kirch80/Trivalent-fridge-controller/Esquemas/Schematic_Trivalent-fridge-controller_power_V1.1.pdf

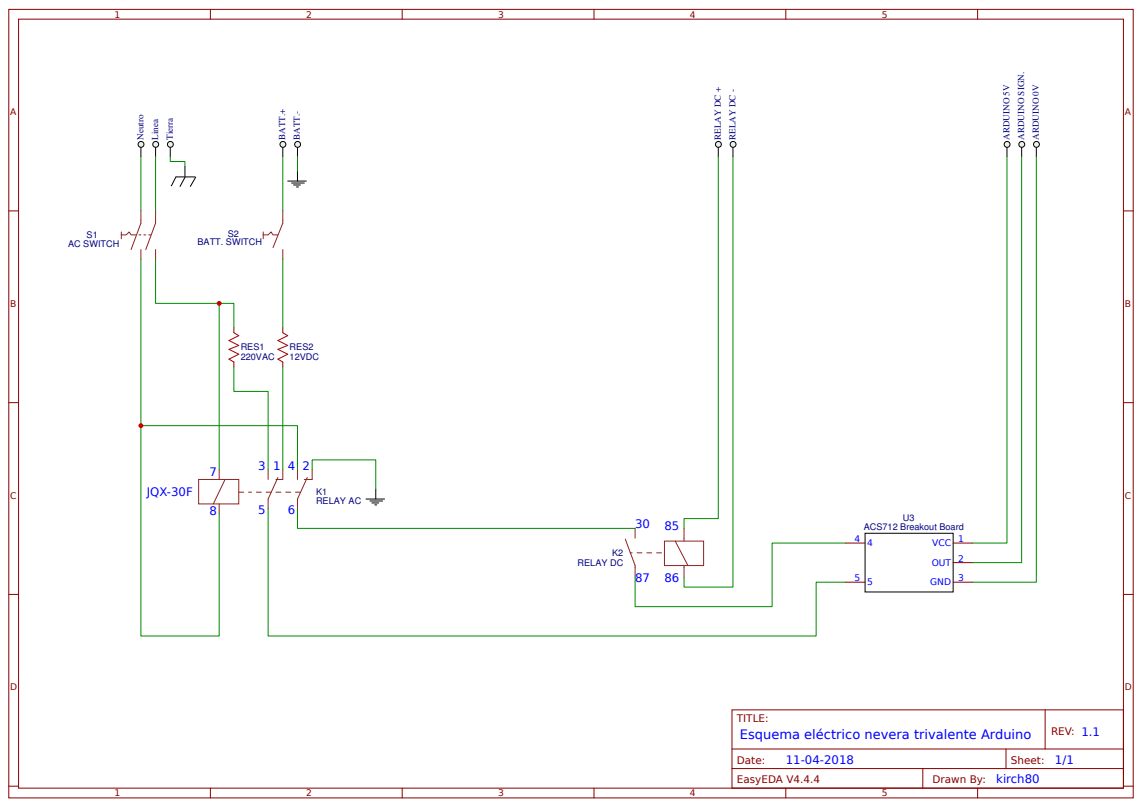
[picture p4: page 1]
TITLE:; Esquema eléctrico nevera trivalente Arduino; REV: 1.1; Date:; Sheet: 1/1; EasyEDA V4.4.4; Drawn By: kirch80; RELAY AC; AC SWITCH; BATT. SWITCH; Neutro; Linea; Tierra; BATT.+; BATT.-; 12VDC; RES2; 220VAC; RES1; RELAY DC; RELAY DC +; RELAY DC -; ACS712 Breakout Board; VCC 1; OUT 2; GND 3; ARDUINO 5V; ARDUINO SIGN.; ARDUINO 0V; JQX-30F
