kirch80/Trivalent-fridge-controller/Esquemas/Schematic_Trivalent-fridge-controller_PCB_V1.0.pdf

+5V

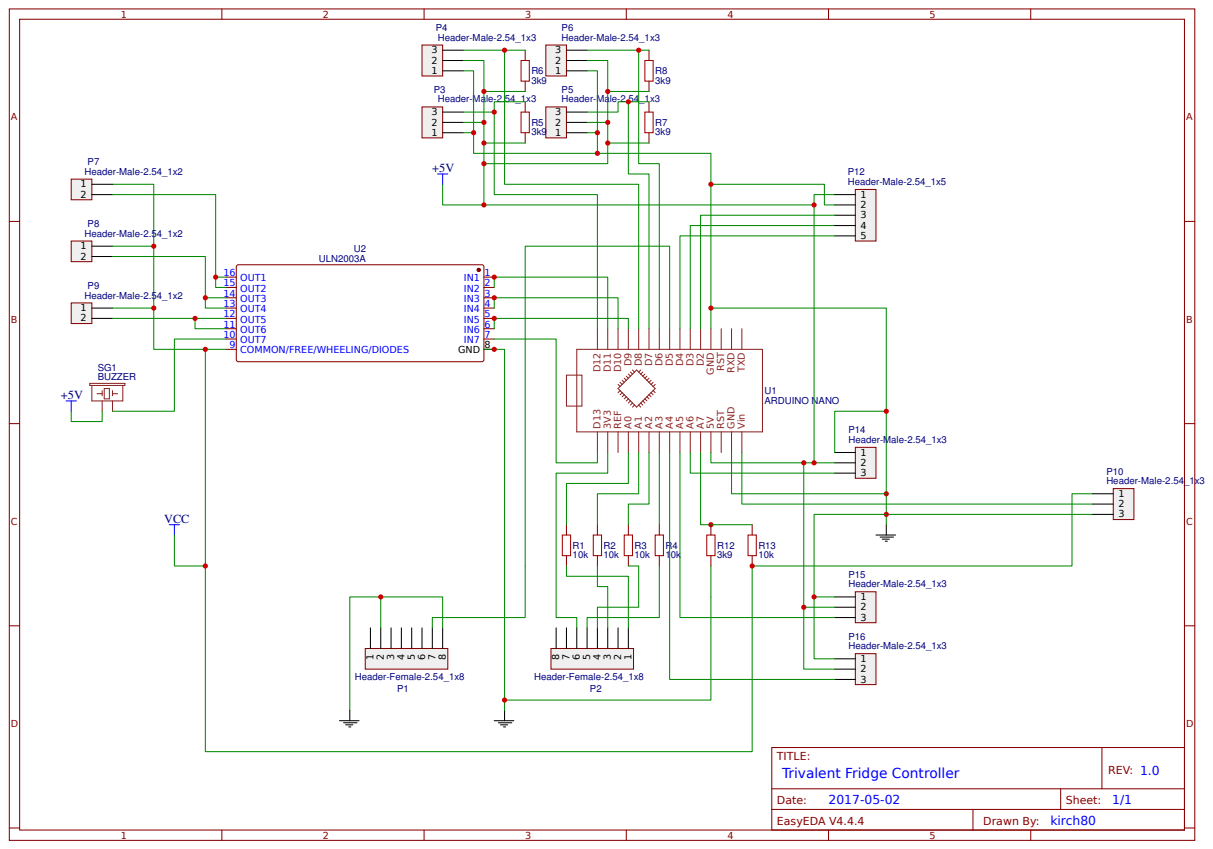
[picture p5: page 1]

GND 8 COMMON/FREE/WHEELING/DIODES 9 OUT7 10 OUT6 11 OUT5 12 OUT4 13 OUT3 14 OUT2 15 OUT1 16
