kirch80/Trivalent-fridge-controller/(commit log)

2018-03-24 Subo la estructura del proyecto al repositorio de GitHub
2018-04-03 Añadido posibilidad de compilar sin sensor congelador
2018-04-03 Correccion versiones en formato correcto
    [Nevera_V1.00.ino, Nevera_V1.01.ino]
2018-04-08 Mejoras graficas modo de trabajo y visualizacion
2018-04-12 Esquemas de potencia actualizados y mejoras librerias
2018-10-03 Several bugs fixed. Tested with IDE 1.8.7. No optiboot needed.
    [Nevera_V1.03.ino]
